stgloorious/EthernetDevBoard.X/hardware/schematics/Schematic_FPGA.pdf

20 | 20 21 21 | 22 22 | 23 23 | 24 24 | 25 25 | 26 26 | 27 27 | 28 28 | 29 29 | 30 30 | 31 31 | 32 32 | 33 33 | 34 34 | 35 35 | 36 36 | 37 37 | 38 38 | 39 39 | 40 40

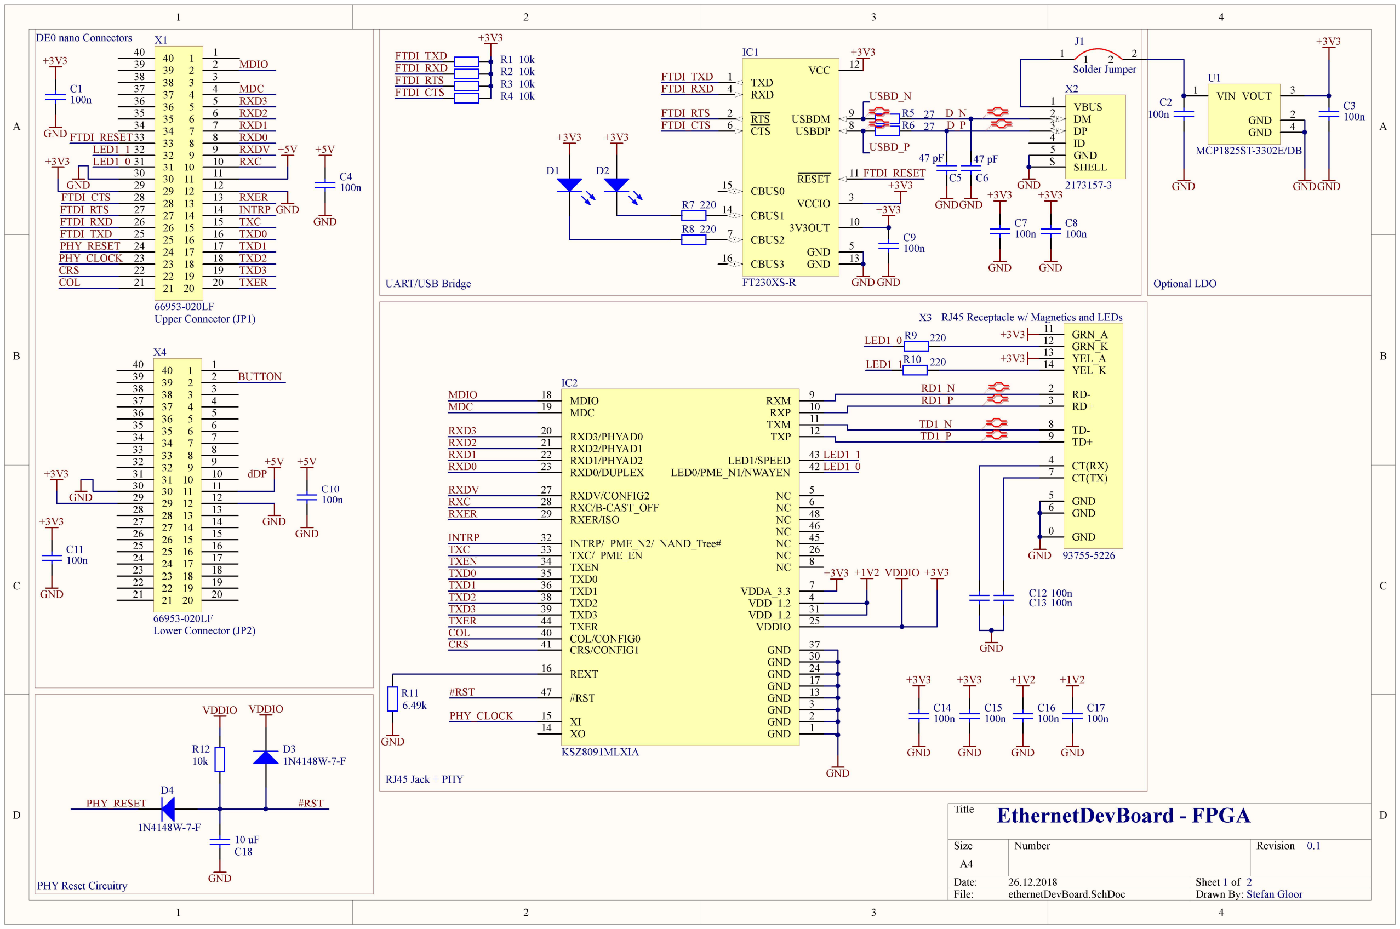
[picture p3: page 1]

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
Title

Size | Number | Revision
A4
Date: | 26.12.2018 | Sheet of
File: | ethernetDevBoard.SchDoc | Drawn By:

# EthernetDevBoard - FPGA

1 2
Stefan Gloor

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
10 10
11 11
12 12
13 13
14 14
15 15
16 16
17 17
18 18
19 19

Upper Connector (JP1)

X1

66953-020LF

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
10 10
11 11
12 12
13 13
14 14
15 15
16 16
17 17
18 18
19 19
20 | 20 21 21 | 22 22 | 23 23 | 24 24 | 25 25 | 26 26 | 27 27 | 28 28 | 29 29 | 30 30 | 31 31 | 32 32 | 33 33 | 34 34 | 35 35 | 36 36 | 37 37 | 38 38 | 39 39 | 40 40

Lower Connector (JP2)

X4

66953-020LF

GND

GND

+5V
+3V3

GND

GND

+5V
+3V3

GND

+3V3 +1V2

MDIO
MDC

RXD3
RXD2
RXD1
RXD0

PHY_CLOCK

#RST

GND

RXDV
RXC
RXER

INTRP
TXC
TXEN
TXD0
TXD1
TXD2
TXD3
TXER
COL
CRS

D4

1N4148W-7-F

D3
1N4148W-7-F

VDDIO

VDDIO

### 10 uF

C18

GND

10k

R12

VDDIO

#RST

R9 220

R10 220

LED1_0

LED1_1

+3V3

+3V3

+3V3

C12 100n
C13 100n

GND

LED1_0

LED1_1

6.49k

R11

GND

MDIO

MDC
RXD3
RXD2

RXD0

RXD1

RXDV
RXC

RXER
INTRP
TXC
TXD0
TXD1
TXD2
TXD3
COL | TXER

CRS

PHY_CLOCK

PHY_RESET

100n

C14

GND

+3V3

100n

C15

GND

+3V3 +1V2

100n

C16

GND

+1V2

100n

C17

GND

100n

C1

GND

+3V3

100n

C11

GND

+3V3

100n

C10

GND

+5V

100n

C4

GND

+5V

TXD 1

RTS 2

VCCIO 3

RXD 4

GND 5

CTS 6

CBUS2 7

USBDP | 8
USBDM | 9
3V3OUT | 10
RESET | 11
VCC | 12
GND | 13

CBUS1 14

CBUS0 15

CBUS3 16

IC1

FT230XS-R | GND

+3V3

FTDI_RESET

+3V3

100n

C7

GND

+3V3

100n

C8

GND

+3V3

VBUS 1
DM 2
DP 3
ID 4
GND 5
SHELL S

X2

GND 2173157-3

R5 27
R6 27

### 47 pF

C5

### 47 pF

C6

R7 220 | GNDGND

R8 220

+3V3 +3V3

FTDI_TXD
FTDI_RXD

FTDI_RTS
FTDI_CTS

100n

C9

GND

R1 10k
R2 10k
R3 10k
R4 10k

FTDI_TXD
FTDI_RXD
FTDI_RTS
FTDI_CTS

+3V3

FTDI_TXD

FTDI_RXD

FTDI_RTS

FTDI_CTS

LED1_0

LED1_1

DE0 nano Connectors

UART/USB Bridge

RJ45 Jack + PHY

PHY Reset Circuitry

PHY_RESET

FTDI_RESET

D_N
D_P

USBD_N

USBD_P

TD1_P

TD1_N

RD1_P

RD1_N

RJ45 Receptacle w/ Magnetics and LEDs

RD- 2
RD+ 3

TD- 8
TD+ 9

CT(RX) 4
CT(TX) 7

GND 5
GND 6

GRN_K 12
YEL_A 13
YEL_K 14

GRN_A 11

GND 0

X3

93755-5226

GND | 1
GND | 2
GND | 3
VDD_1.2 | 4
NC | 5
NC | 6
VDDA_3.3 | 7
GND | 13 GND | 17 GND | 24 GND | 30 GND | 37
NC | 48
NC | 46
NC | 45
VDDIO | 25
NC | 26
NC | 8
RXM | 9
RXP | 10
TXM | 11
TXP | 12
XO 14 | XI 15

REXT 16

MDIO 18
MDC 19

RXD3/PHYAD0 20
RXD2/PHYAD1 21
RXD1/PHYAD2 22
RXD0/DUPLEX 23

RXDV/CONFIG2 27
RXC/B-CAST_OFF 28
RXER/ISO 29

VDD_1.2 31

INTRP/ PME_N2/ NAND_Tree# 32 TXC/ PME_EN 33
TXEN 34
TXD0 35
TXD1 36
TXD2 38
TXD3 39

COL/CONFIG0 40
CRS/CONFIG1 41
LED0/PME_N1/NWAYEN | 42 LED1/SPEED | 43

TXER 44

#RST 47

IC2

KSZ8091MLXIA

D1 | D2

dDP

BUTTON

+3V3

VIN 1

GND | 2
VOUT | 3
GND | 4

U1

MCP1825ST-3302E/DB

+3V3

GND

100n

C3

GND

100n

C2

GND

1

1
2

2

J1

Solder Jumper

Optional LDO
