stgloorious/EthernetDevBoard.X/docs/FPGA6.PNG

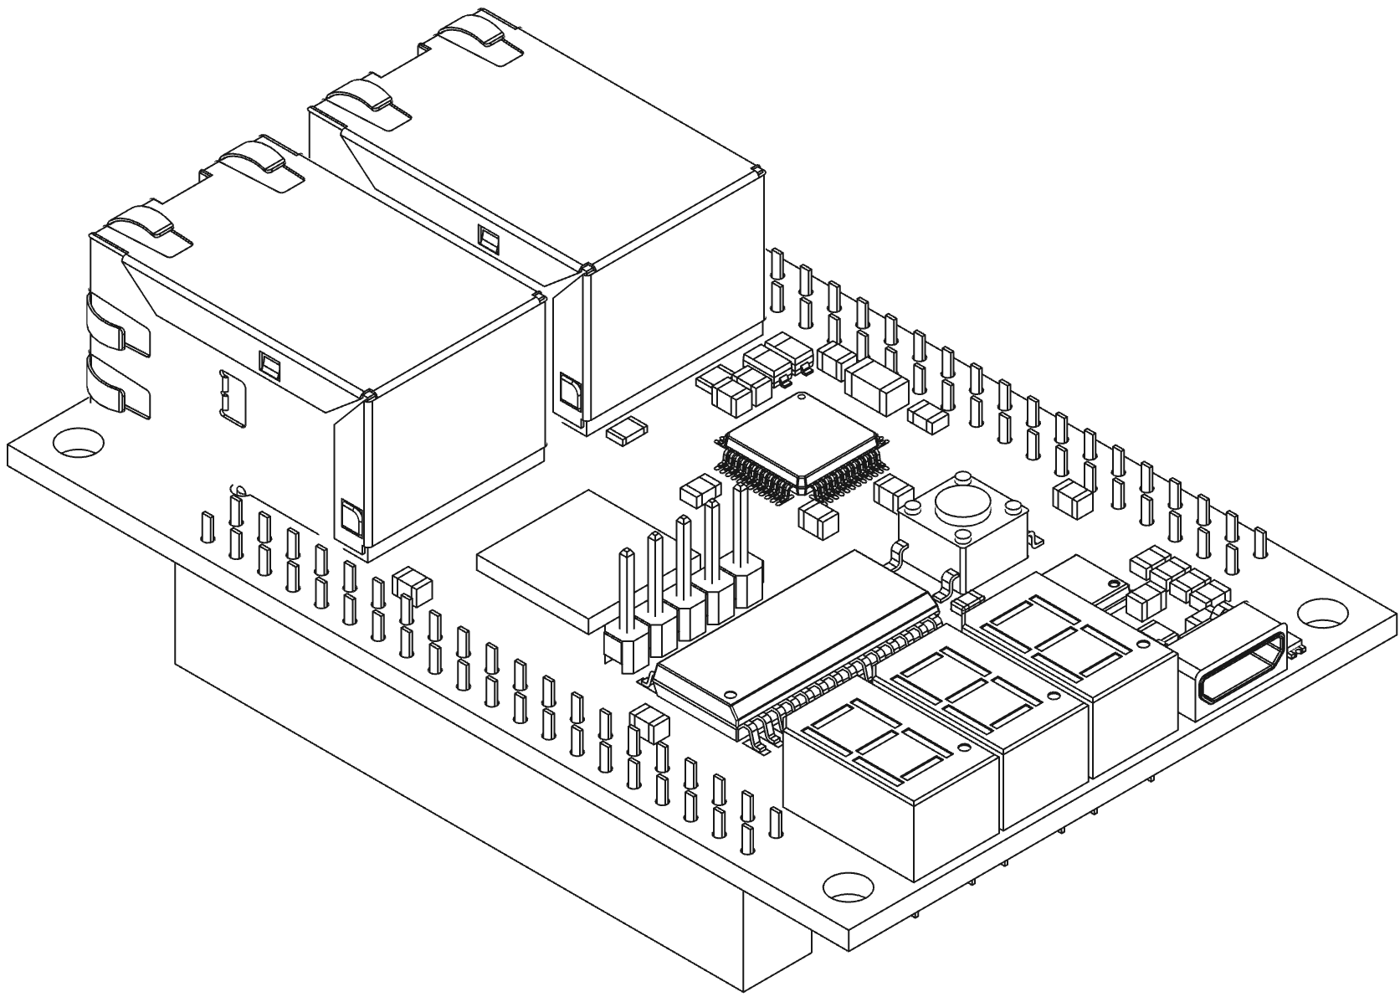
docs/FPGA6.PNG
