stgloorious/EthernetDevBoard.X/docs/hardware_blockdiagram.PNG

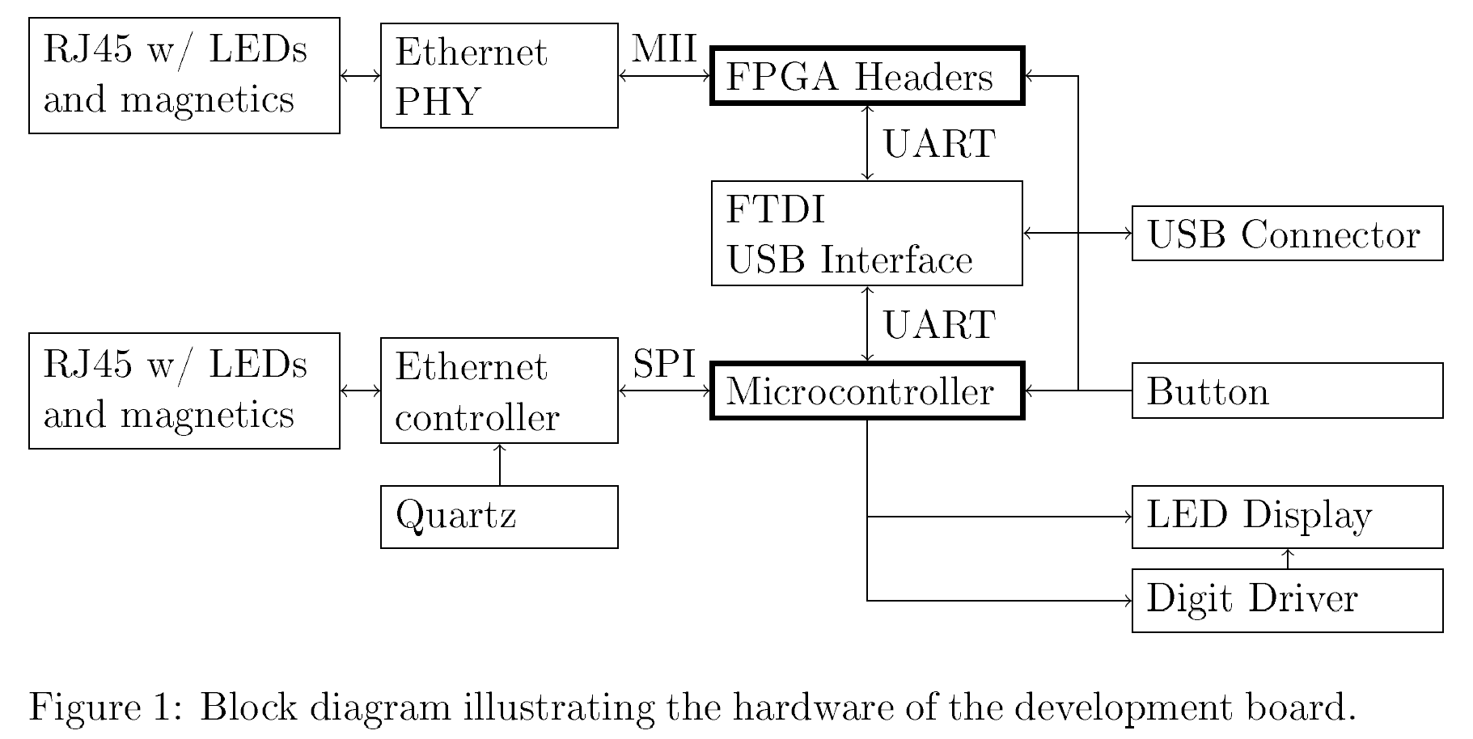
docs/hardware_blockdiagram.PNG
