stgloorious/EthernetDevBoard.X/hardware/photos/1.jpg

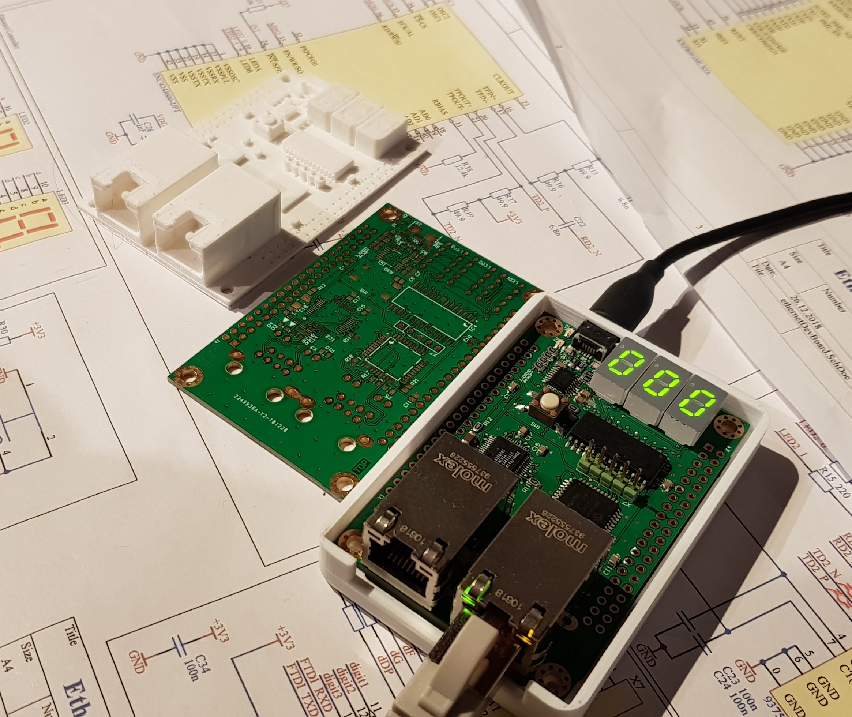
hardware/photos/1.jpg
