stgloorious/EthernetDevBoard.X/hardware/bom/BOM_Full.xls

ETHERNETDEVBOARD_FULL
Mouser No | Mfr. No | Manufacturer | Customer No | Description | RoHS | Lifecycle | Order Qty. | Price (CHF) | Ext.: (CHF)
667-ERJ-6ENF6491V | ERJ-6ENF6491V | Panasonic |  | Thick Film Resistors - SMD 0805 6.49Kohms 1% AEC-Q200 | RoHS Compliant By Exemption |  | 1 | CHF 0.099 | CHF 0.10
667-ERJ-6ENF1002V | ERJ-6ENF1002V | Panasonic |  | Thick Film Resistors - SMD 0805 10Kohms 1% AEC-Q200 | RoHS Compliant By Exemption |  | 7 | CHF 0.099 | CHF 0.69
621-1N4148WQ-7-F | 1N4148WQ-7-F | Diodes Incorporated |  | Diodes - General Purpose, Power, Switching SMT Fast Switching Diode | RoHS Compliant |  | 2 | CHF 0.20 | CHF 0.40
710-885012207086 | 885012207086 | Wurth Electronics |  | Multilayer Ceramic Capacitors MLCC - SMD/SMT WCAP-CSGP 1000pF 0805 10% 50V MLCC | RoHS Compliant |  | 2 | CHF 0.091 | CHF 0.18
710-885012007012 | 885012007012 | Wurth Electronics |  | Multilayer Ceramic Capacitors MLCC - SMD/SMT WCAP-CSGP 22pF 0805 5% 16V MLCC | RoHS Compliant |  | 2 | CHF 0.091 | CHF 0.18
710-885012007032 | 885012007032 | Wurth Electronics |  | Multilayer Ceramic Capacitors MLCC - SMD/SMT WCAP-CSGP 47pF 0805 5% 25V MLCC | RoHS Compliant |  | 2 | CHF 0.099 | CHF 0.20
710-885012207098 | 885012207098 | Wurth Electronics |  | Multilayer Ceramic Capacitors MLCC - SMD/SMT WCAP-CSGP 0.1uF 0805 10% 50V MLCC | RoHS Compliant |  | 25 | CHF 0.064 | CHF 1.60
571-825433-5 | 825433-5 | TE Connectivity | X7 | Headers & Wire Housings 5P SINGLE ROW | RoHS Compliant |  | 1 | CHF 0.697 | CHF 0.70
815-ABMM2-25-E2T | ABMM2-25.000MHZ-E2-T | ABRACON | X6 | Crystals +/-20PPM 25MHZ | RoHS Compliant |  | 1 | CHF 0.827 | CHF 0.83
538-93755-5226 | 93755-5226 | Molex | X3, X5 | Modular Connectors / Ethernet Connectors MXMag FstENeT 4CORE W/TABS W/LED GRN/YLW | RoHS Compliant | New Product | 2 | CHF 6.02 | CHF 12.04
571-2173157-3 | 2173157-3 | TE Connectivity | X2 | USB Connectors SPLASH PROOF MICRO 5P USB B-TYPE | RoHS Compliant |  | 1 | CHF 3.25 | CHF 3.25
649-66953-020LF | 66953-020LF | FCI / Amphenol | X1, X4 | Headers & Wire Housings PCB CONNECTOR 40P | RoHS Compliant |  | 2 | CHF 7.64 | CHF 15.28
579-MCP1825ST3302EDB | MCP1825ST-3302E/DB | Microchip | U1 | LDO Voltage Regulators 500 mA CMOS LDO Vout 3.3V ETR | RoHS Compliant |  | 1 | CHF 0.528 | CHF 0.53
506-2-1437565-8 | 2-1437565-8 | TE Connectivity | SW1 | Tactile Switches TACTILE 260G FORCE S | RoHS Compliant |  | 1 | CHF 0.229 | CHF 0.23
71-CRCW080568R0JNEA | CRCW080568R0JN | Vishay | R22, R23, R24, R25, R | Thick Film Resistors - SMD 1/8watt 68ohms 5% | RoHS Compliant By Exemption |  | 8 | CHF 0.099 | CHF 0.79
71-CRCW080510R0JNEA | CRCW080510R0JNEA | Vishay | R20 | Thick Film Resistors - SMD 1/8watt 10ohms 5% 200ppm | RoHS Compliant By Exemption |  | 1 | CHF 0.099 | CHF 0.10
279-RN73CA-12.4K | RN73C2A12K4BTDF | TE Connectivity | R18 | Thin Film Resistors - SMD 0.1W .1% 10PPM 12.4K | RoHS Compliant |  | 1 | CHF 0.846 | CHF 0.85
667-ERJ-6ENF49R9V | ERJ-6ENF49R9V | Panasonic | R13, R16, R17, R19 | Thick Film Resistors - SMD 0805 49.9ohms 1% AEC-Q200 | RoHS Compliant By Exemption |  | 4 | CHF 0.099 | CHF 0.40
71-CRCW0805220RFKEAH | CRCW0805220RFKEAHP | Vishay | R7, R8, R9, R10, R14, | Thick Film Resistors - SMD 1/2watt 220ohms 1% High Power AEC-Q200 | RoHS Compliant By Exemption |  | 6 | CHF 0.249 | CHF 1.49
71-CRCW080522R0FKEAC | CRCW080522R0FKEAC | Vishay | R5, R6 | Thick Film Resistors - SMD 1/8Watt 22ohms 1% Commercial Use | RoHS Compliant By Exemption | New Product | 2 | CHF 0.099 | CHF 0.20
621-2N7002-F | 2N7002-7-F | Diodes Incorporated | Q1, Q2, Q3 | MOSFET 60V 200mW | RoHS Compliant |  | 3 | CHF 0.189 | CHF 0.57
630-HDSP-7803 | HDSP-7803 | Broadcom Limited | LED1, LED2, LED3 | LED Displays & Accessories Green 571nm 0.3in 7 Segment | RoHS Compliant |  | 3 | CHF 2.90 | CHF 8.70
579-PIC18F25K50-I/SO | PIC18F25K50-I/SO | Microchip | IC4 | 8-bit Microcontrollers - MCU 32 KB Flash RAM, 48 MHz Int. | RoHS Compliant |  | 1 | CHF 2.54 | CHF 2.54
579-ENC424J600-I/PT | ENC424J600-I/PT | Microchip | IC3 | Ethernet ICs 10/100 Base-T Stand alone Ethernet Ctrlr | RoHS Compliant |  | 1 | CHF 3.67 | CHF 3.67
998-KSZ8091MLXIA | KSZ8091MLXIA | Microchip | IC2 | Ethernet ICs 10Base-T/100Base PhysLayerTrnscvr | RoHS Compliant |  | 1 | CHF 1.68 | CHF 1.68
895-FT230XS-R | FT230XS-R | FTDI | IC1 | USB Interface IC USB to Basic Serial UART IC SSOP-16 | RoHS Compliant |  | 1 | CHF 2.03 | CHF 2.03
645-598-8170-107F | 598-8170-107F | Dialight | D1, D2 | Standard LEDs - SMD Green Water Clr 40mcd 570nm | RoHS Compliant |  | 2 | CHF 0.418 | CHF 0.84
710-885012207091 | 885012207091 | Wurth Electronics | C19, C22 | Multilayer Ceramic Capacitors MLCC - SMD/SMT WCAP-CSGP 6800pF 0805 10% 50V MLCC | RoHS Compliant |  | 2 | CHF 0.099 | CHF 0.20
80-C1206X106M4R | C1206X106M4RACTU | KEMET | C18, C25 | Multilayer Ceramic Capacitors MLCC - SMD/SMT 16V 10uF X7R 1206 20% | RoHS Compliant |  | 2 | CHF 1.93 | CHF 3.86
