stgloorious/EthernetDevBoard.X/(list of files, cad)

Other CAD files:
dist/default/production/EthernetDevBoard.X.production.obj
