stgloorious/EthernetDevBoard.X/hardware/mechanical/Mechanical Drawing FPGA.pdf

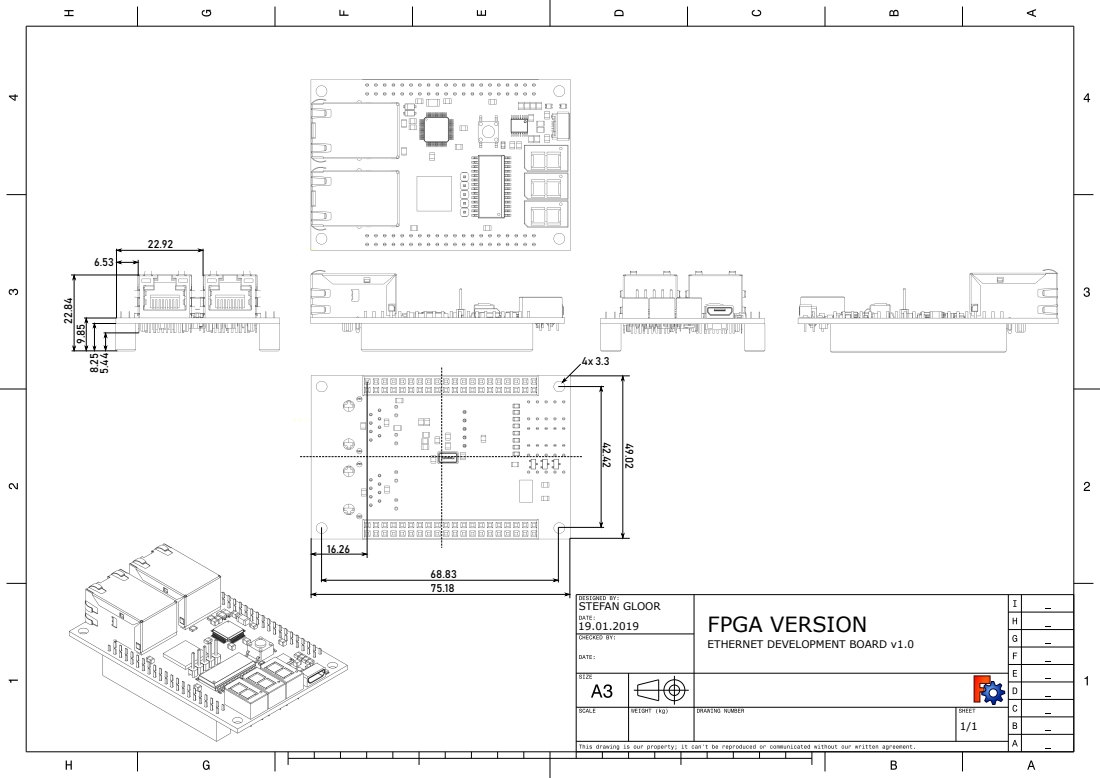
[picture p11: page 1]
STEFAN GLOOR; FPGA VERSION

ETHERNET DEVELOPMENT BOARD v1.0
