stgloorious/EthernetDevBoard.X/hardware/mechanical/Version Differences.pdf

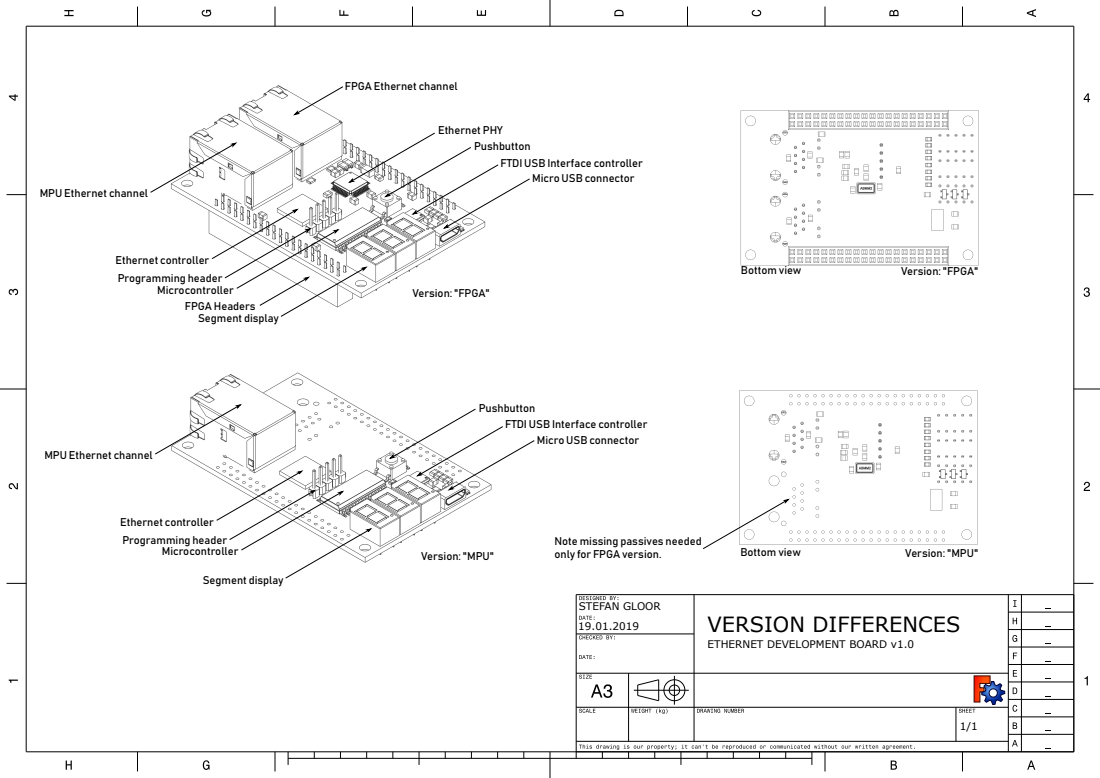
[picture p12: page 1]
STEFAN GLOOR; VERSION DIFFERENCES; Version: "FPGA"; Version: "MPU"; Bottom view; Segment display; FPGA Headers; Microcontroller; Programming header; Ethernet controller

FPGA Ethernet channel

Ethernet PHY
Pushbutton
FTDI USB Interface controller
Micro USB connector

MPU Ethernet channel

Note missing passives needed
only for FPGA version.

ETHERNET DEVELOPMENT BOARD v1.0
