stgloorious/EthernetDevBoard.X/hardware/assembly/Assembly.pdf

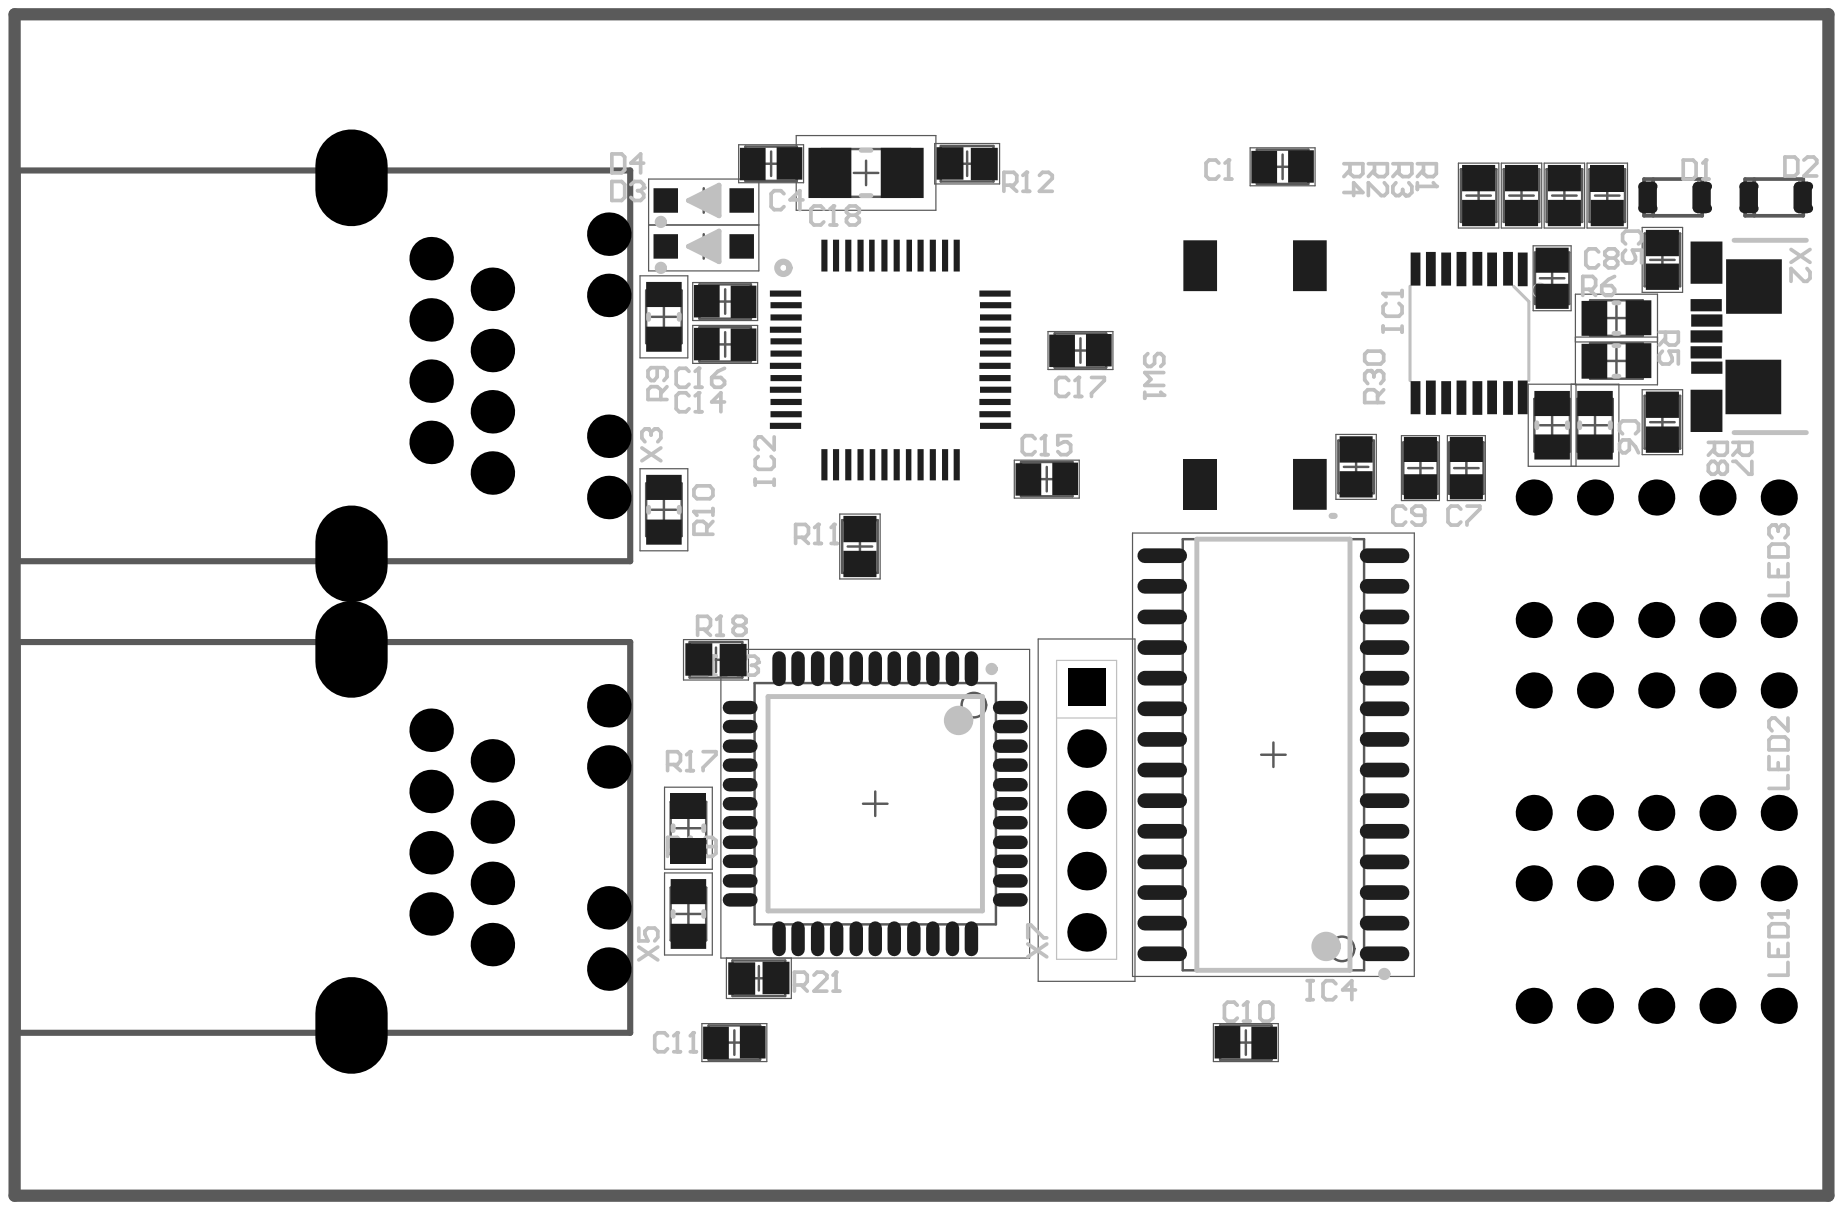
[picture p13: page 1]

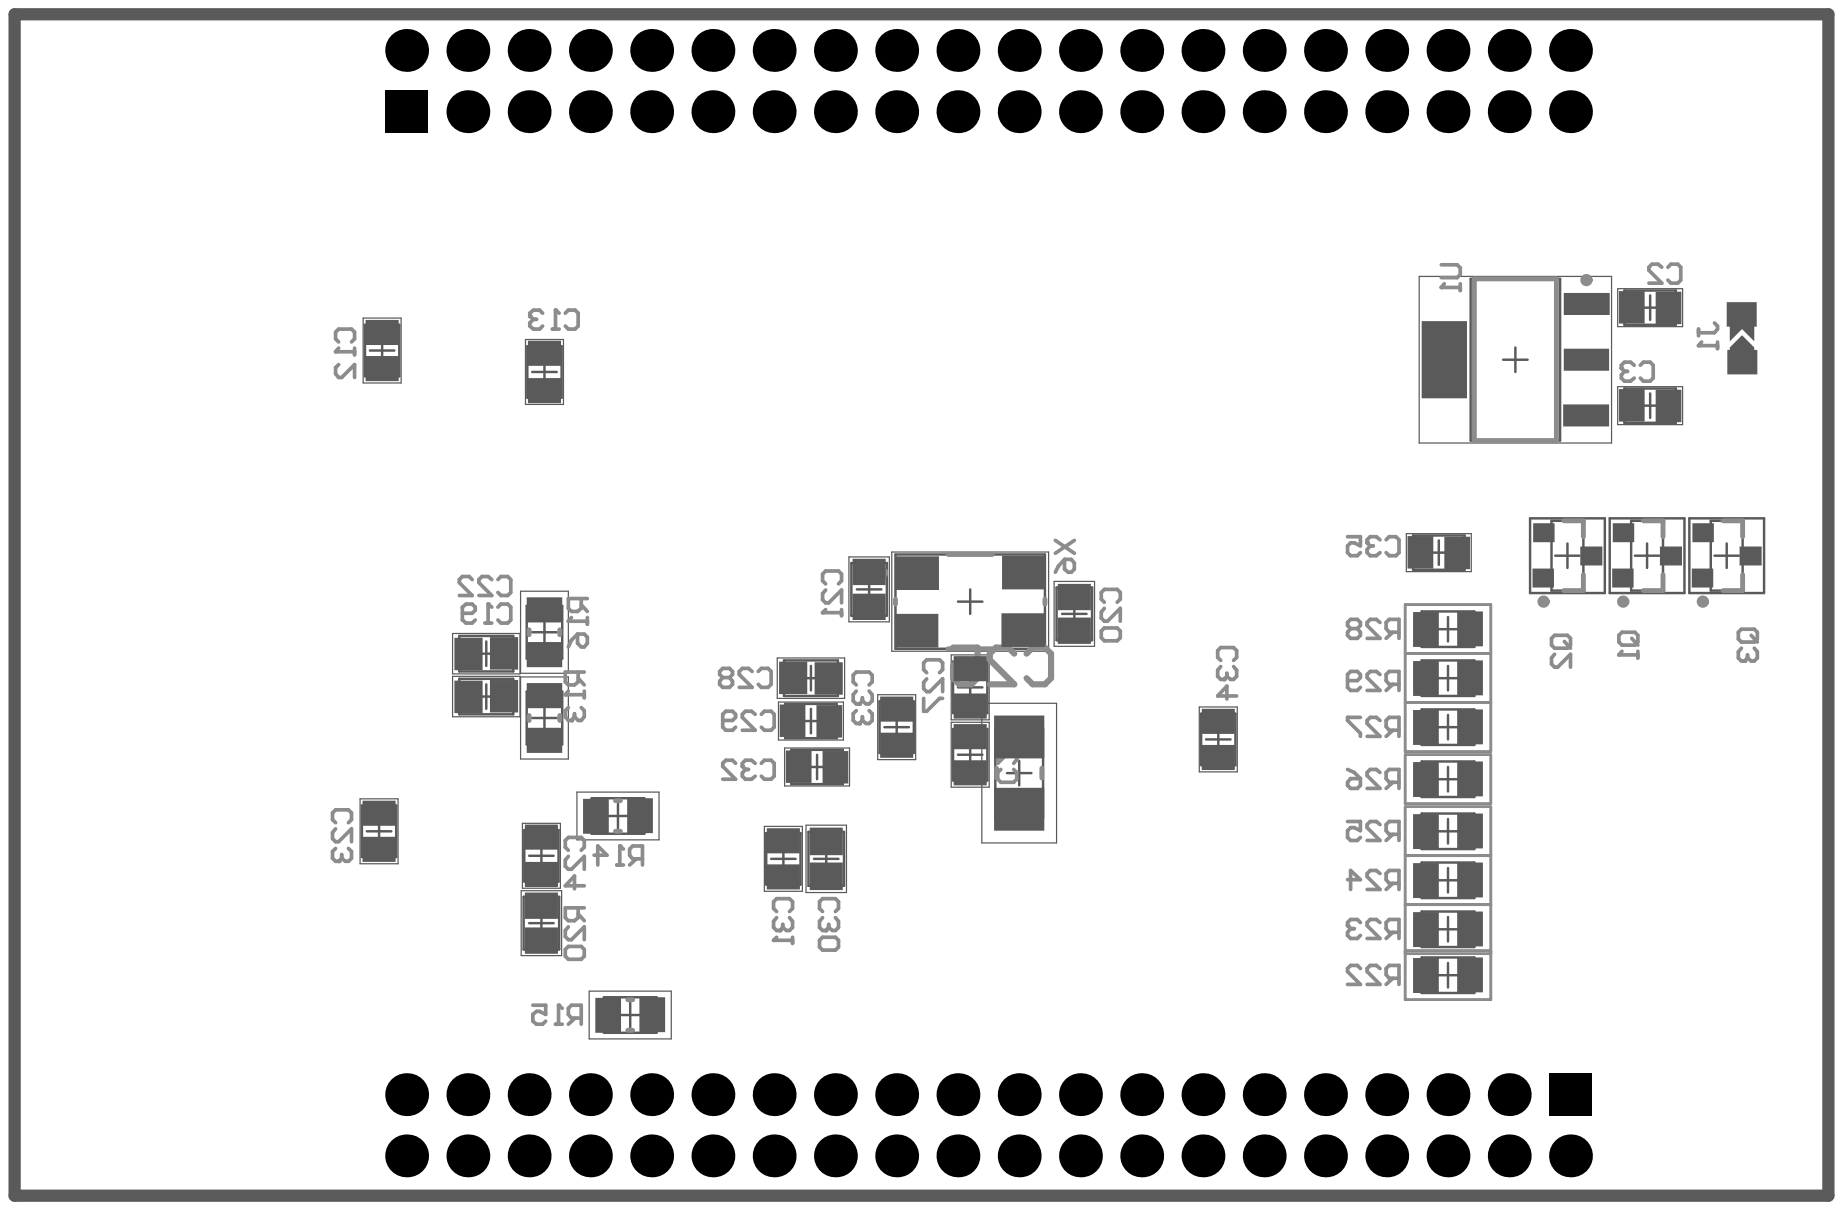
[picture p14: page 2]
