stgloorious/EthernetDevBoard.X/hardware/bom/Version differences.pdf

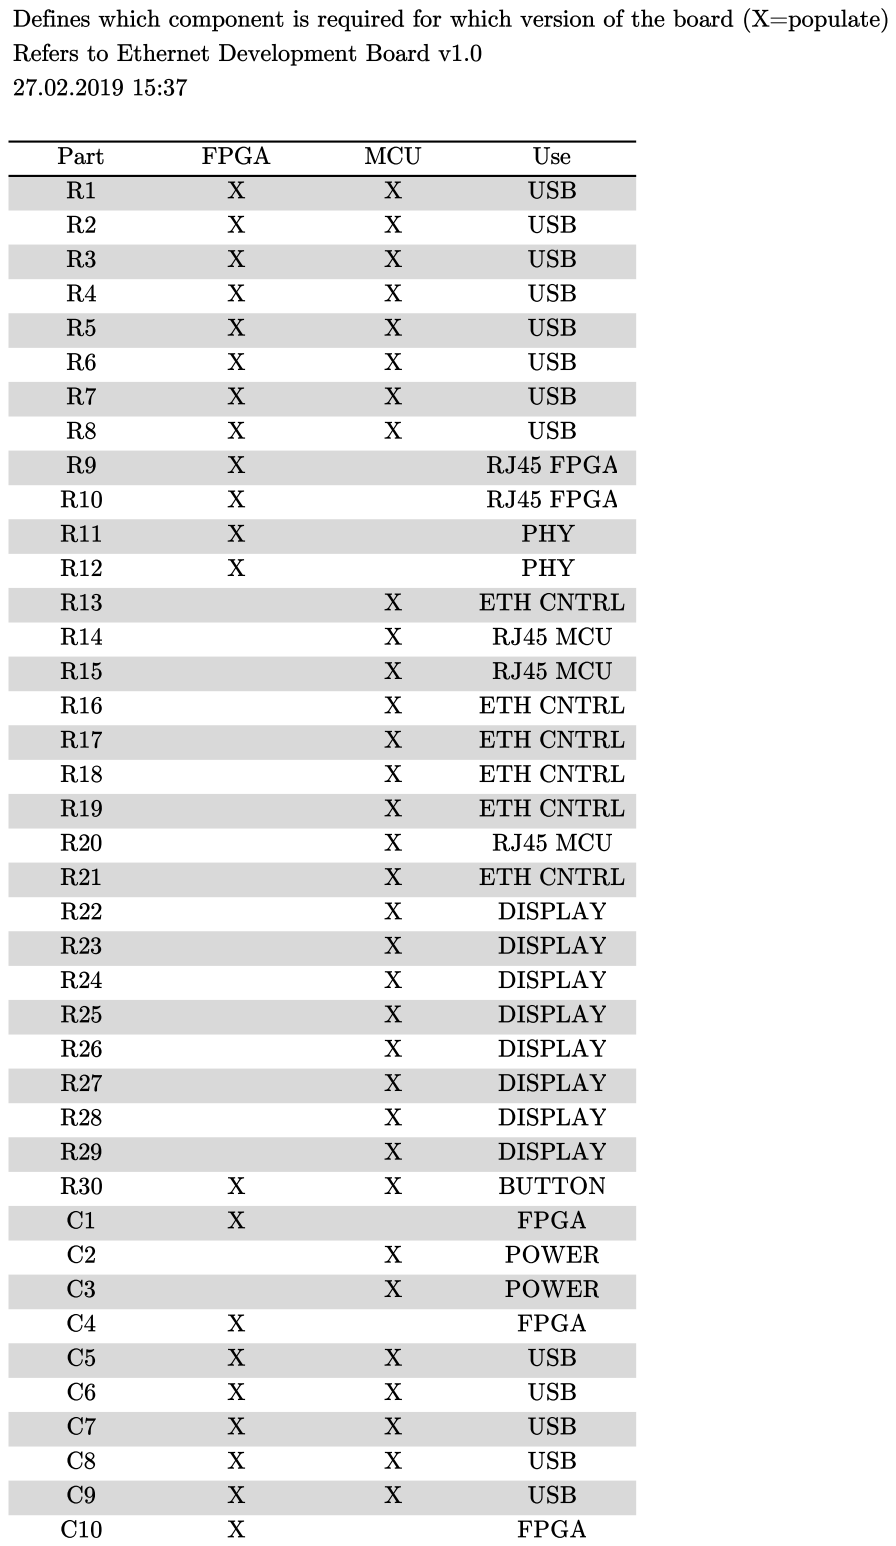
[picture p15: page 1]

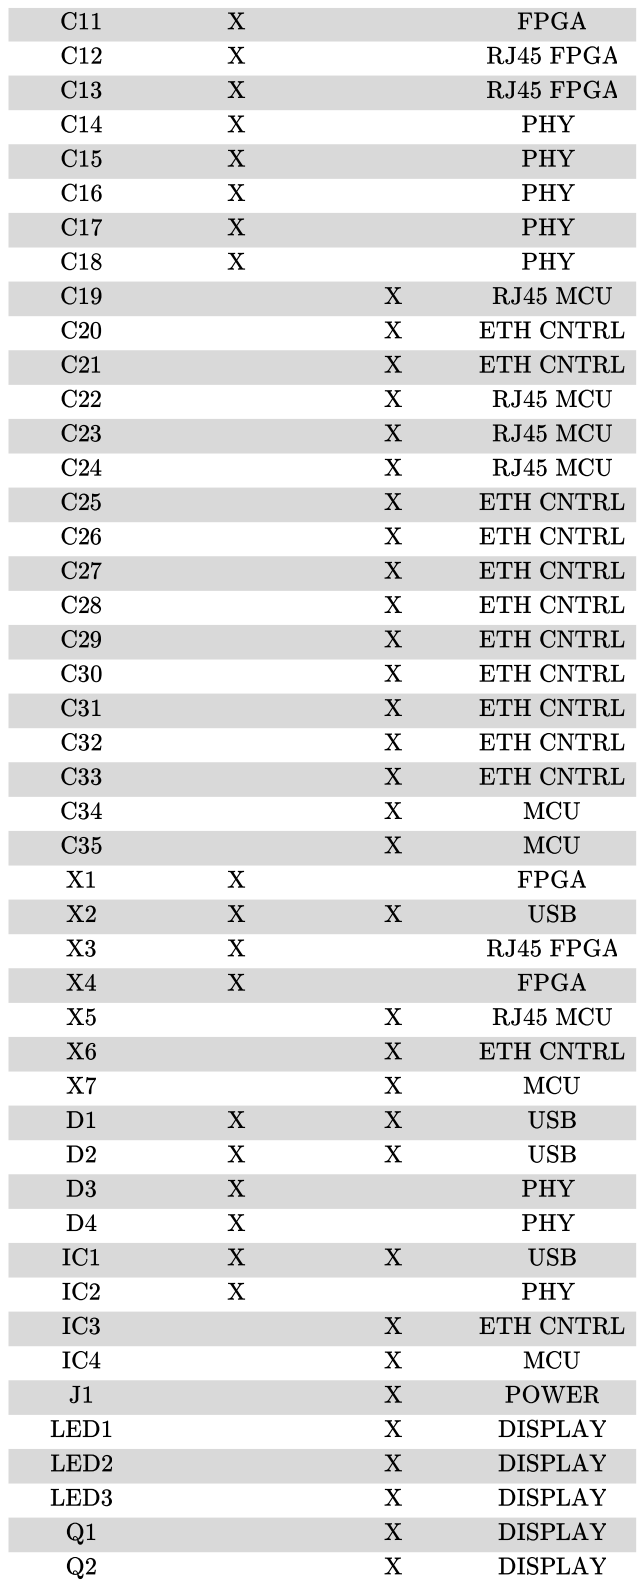
[picture p16: page 2]
