stgloorious/EthernetDevBoard.X/hardware/schematics/Schematic_MPU.pdf

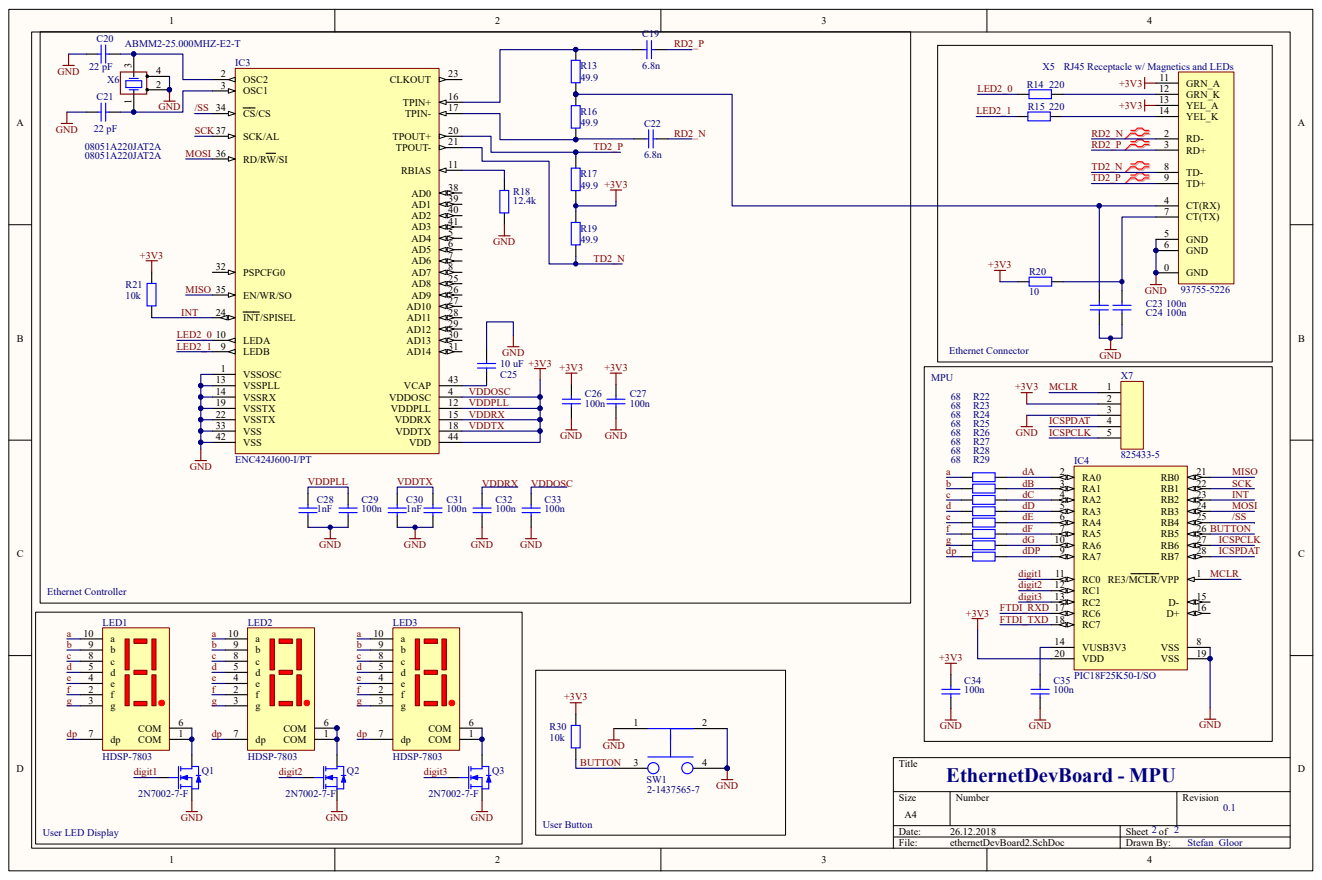
[picture p17: page 1]
