stgloorious/EthernetDevBoard.X/src/system/main.h

/** 
 * \file main.h
 * \brief main
 * \author Stefan Gloor
 * \version 1.0
 * \date  28. December 2018
 * \copyright    
 *  Copyright (C) 2019  Stefan Gloor
 *
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
 *  You should have received a copy of the GNU General Public License
 *  along with this program.  If not, see <http://www.gnu.org/licenses/>.   
 */

#ifndef MAIN_H
#define	MAIN_H

#include <xc.h>
#include <stdint.h>
#include "../eth/ethernetController.h"
#include "../mem/memoryController.h"
#include "../stack/stack.h"
#include "../stack/protocols/ipv4.h"
#include "../system/uart.h"
#include "../system/sevenseg.h"
#include "../stack/backgroundTasks.h"
#include "../system/system.h"



//Button
#define BUTTON_ANSEL	ANSELB &= ~(1<<5)
#define BUTTON_TRISB	TRISB |= (1<<5)
#define BUTTON_STATE	(unsigned)(!(PORTB & (1<<5)))

/**
 * \brief Reads button value and does debouncing and edge-detection
 * \param state Goes to '1' if there's a new edge
 */
void buttonHandler(uint8_t volatile *state);

/**
 * \brief Takes an errorCode type and prints an according message to the user
 * \param err   ErrorCode
 */
void printErrorMessage(error_t err);

/**
 * \brief Prints out debug messages if there is a change in ethernet status
 * \param state Connection state
 */
void printEthernetState (ethernetConnection_t state);

/**
 * \brief Prints out text messages describing the Receive Status Vector.
 * \param rsv Pointer to the first byte out of six of the Receive Status Vector
 */
void printRSV(uint8_t *rsv);


// PIC18F27K42 Configuration Bit Settings

// 'C' source line config statements

// CONFIG1L
#pragma config FEXTOSC = ECH    // External Oscillator Selection (EC (external clock) above 8 MHz; PFM set to high power)
#pragma config RSTOSC = EXTOSC  // Reset Oscillator Selection (EXTOSC operating per FEXTOSC bits (device manufacturing default))

// CONFIG1H
#pragma config CLKOUTEN = OFF   // Clock out Enable bit (CLKOUT function is disabled)
#pragma config PR1WAY = ON      // PRLOCKED One-Way Set Enable bit (PRLOCK bit can be cleared and set only once)
#pragma config CSWEN = ON       // Clock Switch Enable bit (Writing to NOSC and NDIV is allowed)
#pragma config FCMEN = ON       // Fail-Safe Clock Monitor Enable bit (Fail-Safe Clock Monitor enabled)

// CONFIG2L
#pragma config MCLRE = EXTMCLR  // MCLR Enable bit (If LVP = 0, MCLR pin is MCLR; If LVP = 1, RE3 pin function is MCLR )
#pragma config PWRTS = PWRT_OFF // Power-up timer selection bits (PWRT is disabled)
#pragma config MVECEN = ON      // Multi-vector enable bit (Multi-vector enabled, Vector table used for interrupts)
#pragma config IVT1WAY = ON     // IVTLOCK bit One-way set enable bit (IVTLOCK bit can be cleared and set only once)
#pragma config LPBOREN = OFF    // Low Power BOR Enable bit (ULPBOR disabled)
#pragma config BOREN = SBORDIS  // Brown-out Reset Enable bits (Brown-out Reset enabled , SBOREN bit is ignored)

// CONFIG2H
#pragma config BORV = VBOR_2P45 // Brown-out Reset Voltage Selection bits (Brown-out Reset Voltage (VBOR) set to 2.45V)
#pragma config ZCD = OFF        // ZCD Disable bit (ZCD disabled. ZCD can be enabled by setting the ZCDSEN bit of ZCDCON)
#pragma config PPS1WAY = ON     // PPSLOCK bit One-Way Set Enable bit (PPSLOCK bit can be cleared and set only once; PPS registers remain locked after one clear/set cycle)
#pragma config STVREN = ON      // Stack Full/Underflow Reset Enable bit (Stack full/underflow will cause Reset)
#pragma config DEBUG = OFF      // Debugger Enable bit (Background debugger disabled)
#pragma config XINST = OFF      // Extended Instruction Set Enable bit (Extended Instruction Set and Indexed Addressing Mode disabled)

// CONFIG3L
#pragma config WDTCPS = WDTCPS_31// WDT Period selection bits (Divider ratio 1:65536; software control of WDTPS)
#pragma config WDTE = ON        // WDT operating mode (WDT enabled regardless of sleep)

// CONFIG3H
#pragma config WDTCWS = WDTCWS_7// WDT Window Select bits (window always open (100%); software control; keyed access not required)
#pragma config WDTCCS = SC      // WDT input clock selector (Software Control)

// CONFIG4L
#pragma config BBSIZE = BBSIZE_512// Boot Block Size selection bits (Boot Block size is 512 words)
#pragma config BBEN = OFF       // Boot Block enable bit (Boot block disabled)
#pragma config SAFEN = OFF      // Storage Area Flash enable bit (SAF disabled)
#pragma config WRTAPP = OFF     // Application Block write protection bit (Application Block not write protected)

// CONFIG4H
#pragma config WRTB = OFF       // Configuration Register Write Protection bit (Configuration registers (300000-30000Bh) not write-protected)
#pragma config WRTC = OFF       // Boot Block Write Protection bit (Boot Block (000000-0007FFh) not write-protected)
#pragma config WRTD = OFF       // Data EEPROM Write Protection bit (Data EEPROM not write-protected)
#pragma config WRTSAF = OFF     // SAF Write protection bit (SAF not Write Protected)
#pragma config LVP = ON         // Low Voltage Programming Enable bit (Low voltage programming enabled. MCLR/VPP pin function is MCLR. MCLRE configuration bit is ignored)

// CONFIG5L
#pragma config CP = OFF         // PFM and Data EEPROM Code Protection bit (PFM and Data EEPROM code protection disabled)

// CONFIG5H

// #pragma config statements should precede project file includes.
// Use project enums instead of #define for ON and OFF.

#endif	 /* MAIN_H */
