stgloorious/EthernetDevBoard.X/src/stack/protocols/arp.c

/** 
 * \file arp.c
 * \brief Function definitions for IPv4
 * \author Stefan Gloor
 * \version 1.0
 * \date 1. Februar 2019
 * \ingroup arp
 * \copyright    
 *  Copyright (C) 2019  Stefan Gloor
 *
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
 *  You should have received a copy of the GNU General Public License
 *  along with this program.  If not, see <http://www.gnu.org/licenses/>. 
 */

#include <stdlib.h>
#include "arp.h"


arp_tableEntry_t static arp_table [ARP_TABLE_LENGTH];

/* =======================  Receive  ======================= */

void arp_handleNewPacket(ethernetFrame_t *frame) {
    arp_message_t arp;
    if (frame->ethertype != ETHERTYPE_ARP) {
        ethernetController_dropPacket(frame);
        return;
    }

    arp = arp_parseFromRXBuffer(frame);
    if (arp.err.code != ERROR_CODE_SUCCESSFUL) {
        ethernetController_dropPacket(frame);
#if ARP_DEBUG_MESSAGES==true
        UARTTransmitText("[Invalid ARP Message was discarded.]\r\n");
#endif
        return;
    }
#if ARP_DEBUG_MESSAGES==true
    UARTTransmitText("[");
    UARTTransmitText(macToString(arp.senderMACAddress));
    UARTTransmitText(", ");
    UARTTransmitText(ipAdressToString(arp.senderIPAddress));
    UARTTransmitText("]->[");
    UARTTransmitText(macToString(arp.targetMACAddress));
    UARTTransmitText(", ");
    UARTTransmitText(ipAdressToString(arp.targetIPAddress));
    UARTTransmitText("]");
    UART_setFormat(UART_COLOR_FG_BLUE);
    if (arp.fIsProbe)
        UARTTransmitText("[IsProbe]");
    if (arp.fIsGratuitous)
        UARTTransmitText("[IsGratuitous]");
    UART_resetFormat();
#endif 
    arp_sendReply(arp);
    if (!ipv4_isAllZero(&arp.senderIPAddress)) {//Don't allow entries with 0.0.0.0
        arp_setNewEntry(arp.senderMACAddress, arp.senderIPAddress, getMillis());
    }
    ethernetController_dropPacket();
}

arp_message_t static arp_parseFromRXBuffer(ethernetFrame_t *frame) {
    arp_message_t arp;
    uint16_t const offset = 22; //skip NextPacketPointer (2 Bytes), RSV (6 Bytes), 2 MAC addresses (12 Bytes) and EtherType (2 Bytes)

    ethernetController_streamFromRXBuffer(0, frame->memory.start + offset); //Prepare stream

    //Word 0
    arp.htype = (ethernetController_streamFromRXBuffer(1, frame->memory.start + offset) << 8);
    arp.htype |= ethernetController_streamFromRXBuffer(1, frame->memory.start + offset);
    //Word 1
    arp.ptype = (ethernetController_streamFromRXBuffer(1, frame->memory.start + offset) << 8);
    arp.ptype |= ethernetController_streamFromRXBuffer(1, frame->memory.start + offset);
    //Word 2
    arp.hlen = ethernetController_streamFromRXBuffer(1, frame->memory.start + offset);
    arp.plen = ethernetController_streamFromRXBuffer(1, frame->memory.start + offset);
    //Word 3
    arp.operation = (ethernetController_streamFromRXBuffer(1, frame->memory.start + offset) << 8);
    arp.operation |= ethernetController_streamFromRXBuffer(1, frame->memory.start + offset);

    // Sender Addresses
    for (uint8_t i = 0; i < arp.hlen; i++)
        arp.senderMACAddress.address[i] = ethernetController_streamFromRXBuffer(1, frame->memory.start + offset);
    for (uint8_t i = 0; i < arp.plen; i++)
        arp.senderIPAddress.address[i] = ethernetController_streamFromRXBuffer(1, frame->memory.start + offset);
    //Target Addresses
    for (uint8_t i = 0; i < arp.hlen; i++)
        arp.targetMACAddress.address[i] = ethernetController_streamFromRXBuffer(1, frame->memory.start + offset);
    for (uint8_t i = 0; i < arp.plen; i++)
        arp.targetIPAddress.address[i] = ethernetController_streamFromRXBuffer(1, frame->memory.start + offset);

    ethernetController_streamFromRXBuffer(2, frame->memory.start + offset); //Close stream

    if (ipv4_isAllZero(&arp.senderIPAddress)) {//Is it an ARP Probe?
        arp.fIsProbe = 1;
        arp.fIsGratuitous = 0;
    } else {//If not it may be gratuitous
        arp.fIsProbe = 0;
        //Is SPA=TPA and THA set to zero in a ARP request ?
        if (ipv4_cmp(&arp.senderIPAddress, &arp.targetIPAddress) &&
                mac_isAllZero(&arp.targetMACAddress) &&
                arp.operation == ARP_REQUEST) {
            arp.fIsGratuitous = 1;
        } else {
            //Is SPA=TPA and THA=SHA in a ARP reply ?
            if (ipv4_cmp(&arp.senderIPAddress, &arp.targetIPAddress) &&
                    mac_cmp(&arp.senderMACAddress, &arp.targetMACAddress) &&
                    arp.operation == ARP_REPLY) {
                arp.fIsGratuitous = 1;
            } else {
                arp.fIsGratuitous = 0;
            }
        }
    }

    //was there anything unexpected?
    if ((arp.htype != ARP_HTYPE_ETHERNET) || //only Ethernet is supported
            (arp.ptype != ARP_PTYPE_IPv4) || //only IPv4
            (arp.operation > 2) || //There is nothing else than REQUEST (1) and REPLY (2)
            (arp.hlen != ARP_ETHERNET_HLEN) ||
            (arp.plen != ARP_IPv4_PLEN)) {
        arp.err.code = ERROR_ARP_INVALID_VALUES;
        arp.err.module = ERROR_MODULE_ARP;
    } else {
        arp.err.code = ERROR_CODE_SUCCESSFUL;
        arp.err.module = ERROR_MODULE_ARP;
    }

    return arp;
}

/* =======================  Transmit  ======================= */

void static arp_send(arp_message_t arp) {
    memoryField_t field;
    ethernetFrame_t ethFrame;

#if ARP_LINK_BROADCAST == true
    macaddress_t destination;
    mac_setToBroadcast(&destination);
    ethFrame.destination = destination; //broadcast address
#else
    ethFrame.destination = arp.targetMACAddress;
#endif
    ethFrame.length = 36;
    ethFrame.source = ethernetController_getSourceMACAddress(field);
    ethFrame.ethertype = ETHERTYPE_ARP;

    ethernet_txFrameRequest(&ethFrame);

    if (ethFrame.memory.fOutOfMemory) {
        return;
    }

    field.start = ethFrame.memory.start + 8;
    field.end = ethFrame.memory.end;
    field.length = 28;

    ethernetController_streamToTransmitBuffer((arp.htype & 0xff00) >> 8, field);
    ethernetController_streamToTransmitBuffer(arp.htype & 0x00ff, field);
    ethernetController_streamToTransmitBuffer((arp.ptype & 0xff00) >> 8, field);
    ethernetController_streamToTransmitBuffer(arp.ptype & 0x00ff, field);
    ethernetController_streamToTransmitBuffer(arp.hlen, field);
    ethernetController_streamToTransmitBuffer(arp.plen, field);
    ethernetController_streamToTransmitBuffer((arp.operation & 0xff00) >> 8, field);
    ethernetController_streamToTransmitBuffer(arp.operation & 0x00ff, field);
    for (uint8_t i = 0; i < arp.hlen; i++)
        ethernetController_streamToTransmitBuffer(arp.senderMACAddress.address[i], field);
    for (uint8_t i = 0; i < arp.plen; i++)
        ethernetController_streamToTransmitBuffer(arp.senderIPAddress.address[i], field);
    for (uint8_t i = 0; i < arp.hlen; i++)
        ethernetController_streamToTransmitBuffer(arp.targetMACAddress.address[i], field);
    for (uint8_t i = 0; i < arp.plen; i++)
        ethernetController_streamToTransmitBuffer(arp.targetIPAddress.address[i], field);

    ethernetController_sendPacket(ethFrame.memory);
}

/* =======================  Messages  ======================= */
void arp_sendRequest(ipv4_address_t ipSender, ipv4_address_t ipTarget) {
    arp_message_t request;
    macaddress_t senderMAC;
    macaddress_t targetMAC;

    senderMAC = ethernetController_getMacAddress();
    mac_setAllZero(&targetMAC);

    request.hlen = ARP_ETHERNET_HLEN;
    request.plen = ARP_IPv4_PLEN;
    request.htype = ARP_HTYPE_ETHERNET;
    request.ptype = ARP_PTYPE_IPv4;
    request.operation = ARP_REQUEST;
    request.senderIPAddress = ipSender;
    request.senderMACAddress = senderMAC;
    request.targetIPAddress = ipTarget;
    request.targetMACAddress = targetMAC;

    arp_send(request);
}

void static arp_sendReply(arp_message_t request) {
    if (request.operation != ARP_REQUEST)//is it a request?
        return;

    ipv4_address_t myIP = ipv4_getIPSourceAddress();
    if (!(ipv4_cmp(&request.targetIPAddress, &myIP))) //For my IP Address?
        return;

    arp_message_t reply;
    ipv4_address_t senderIP;
    ipv4_address_t targetIP;
    macaddress_t senderMAC;
    macaddress_t targetMAC;

    senderMAC = ethernetController_getMacAddress();
    targetMAC = request.senderMACAddress; //send it back
    senderIP = ipv4_getIPSourceAddress();
    targetIP = request.senderIPAddress; //send it back

    reply.hlen = ARP_ETHERNET_HLEN;
    reply.plen = ARP_IPv4_PLEN;
    reply.htype = ARP_HTYPE_ETHERNET;
    reply.ptype = ARP_PTYPE_IPv4;
    reply.operation = ARP_REPLY;
    reply.senderIPAddress = senderIP;
    reply.senderMACAddress = senderMAC;
    reply.targetIPAddress = targetIP;
    reply.targetMACAddress = targetMAC;

    arp_send(reply);
#if ARP_DEBUG_MESSAGES==true
    UART_setFormat(UART_COLOR_BG_BLUE); //blue color, Primary font
    UARTTransmitText("[Reply sent to ");
    UARTTransmitText(macToString(reply.targetMACAddress));
    UARTTransmitText(", ");
    UARTTransmitText(ipAdressToString(reply.targetIPAddress));
    UARTTransmitText("]");
    UART_resetFormat();
#endif
}

/* =======================  Collision Check  ======================= */
error_t static arp_probe(ipv4_address_t ipTarget, linkState_t link) {
    time_t timeStart; // Used to calculate the time passed
    time_t waitingTime; // Specifies the number of milliseconds which have to pass before doing something
    ipv4_address_t ipSender;
    uint8_t static probeCounter = 0; //counts how many probes already have been sent
    error_t err;

    enum states {
        PREPARING_PROBE, WAITING_TO_SEND, SENDING_PROBE, ARP_ENTRY_FOUND
    };
    uint8_t static state = PREPARING_PROBE;
    uint8_t index;
    err.module = ERROR_MODULE_ARP;

    if (link == NO_LINK) {
        state = PREPARING_PROBE;
        probeCounter = 0;
        err.code = ERROR_ARP_CONNECTION_FAILED;
        return err; //don't bother to continue
    }

    if (arp_checkForEntry(ipTarget, &index)) {
        state = ARP_ENTRY_FOUND;
    }

    switch (state) {//State Machine
        case PREPARING_PROBE:
            ipv4_setToAllZero(&ipSender); //"The 'sender IP address' field MUST be set to all zeroes" - RFC 5227
            timeStart = getMillis(); //keep track when we started counting the waitingTime
            waitingTime = rand() % ARP_PROBE_WAIT; //"[...] then wait for a random time interval selected uniformly in the range zero to PROBE_WAIT" - RFC 5227
            state = WAITING_TO_SEND;
            err.code = ERROR_ARP_WAITING;
            break;
        case WAITING_TO_SEND:
            if (getMillis() - timeStart >= waitingTime) {//Are we done waiting for the first probe?
                state = SENDING_PROBE;
                //"[...] each of these probe packets spaced randomly and uniformly, PROBE_MIN to PROBE_MAX seconds apart." - RFC 5227
                waitingTime = (rand() % (ARP_PROBE_MAX - ARP_PROBE_MIN)) + ARP_PROBE_MIN;
            }
            err.code = ERROR_ARP_WAITING;
            break;
        case SENDING_PROBE:
            if (probeCounter == 0 || (getMillis() - timeStart) > waitingTime) {
                timeStart = getMillis(); //remember time the last packet was sent

                if (probeCounter < ARP_PROBE_NUM) {
#if ARP_DEBUG_MESSAGES==true
                    UARTTransmitText("[ARP]: Sending Probe for ");
                    UARTTransmitText(ipAdressToString(ipTarget));
                    UARTTransmitText(" (reply to ");
                    UARTTransmitText(ipAdressToString(ipSender));
                    UARTTransmitText(")\n\r");
#endif
                    arp_sendRequest(ipSender, ipTarget);
                }
                if (probeCounter >= ARP_PROBE_NUM) {//RFC suggests to wait *after* the transmission
                    probeCounter = 0;
                    state = PREPARING_PROBE;
                    err.code = ERROR_ARP_MAXIMUM_NUMBER_OF_PROBES_REACHED; //That would be the "normal" case; the probing was negative
                } else {
                    err.code = ERROR_ARP_WAITING; //there are more probes to send
                    probeCounter++;
                }
            }
            break;
        case ARP_ENTRY_FOUND:
            probeCounter = 0;
            state = PREPARING_PROBE;
            err.code = ERROR_ARP_IPv4_ADDRESS_CONFLICT;
    }
    return err; //Is reached as long as link is connected
}

error_t static arp_gratuitous(ipv4_address_t ip, linkState_t link) {
    uint8_t static announceCounter = 0;
    uint8_t static state = 0;
    time_t static timeStart = 0;
    uint8_t index;
    error_t err;

    enum states {
        INIT, WAIT_FOR_ANNOUNCE, ANNOUNCING, ENTRY_FOUND
    };
    err.module = ERROR_MODULE_ARP;
    err.code = ERROR_ARP_WAITING;

    if (link == NO_LINK) {
        announceCounter = 0;
        state = INIT;
        err.code = ERROR_ARP_CONNECTION_FAILED;
        return err;
    }

    if (arp_checkForEntry(ip, &index)) {
        state = ENTRY_FOUND;
    }

    switch (state) {//state machine
        case INIT://used to determine the start time
            err.code = ERROR_ARP_WAITING;
            timeStart = getMillis();
            state = WAIT_FOR_ANNOUNCE;
            break;
        case WAIT_FOR_ANNOUNCE://waiting ANNOUNCE_WAIT
            err.code = ERROR_ARP_WAITING;
            if ((getMillis() - timeStart) > ARP_ANNOUNCE_WAIT) {
                state = ANNOUNCING; //done waiting
                announceCounter = 0;
            }
            break;
        case ANNOUNCING://Ready to announce
            err.code = ERROR_ARP_WAITING;
            if ((announceCounter == 0) || (getMillis() - timeStart) > ARP_ANNOUNCE_INTERVAL) {//Wait ANNOUNCE_INTERVAL between announcements
#if ARP_DEBUG_MESSAGES==true
                UARTTransmitText("[ARP]: Sending Gratuitous ARP request for ");
                UARTTransmitText(ipAdressToString(ip));
                UARTTransmitText("\n\r");
#endif
                timeStart = getMillis(); //memorise time when the last announcement was sent
                arp_sendRequest(ip, ip); //Sender and target IP are the newly selected address
                announceCounter++;
            }
            if (announceCounter >= ARP_ANNOUNCE_NUM) {
                //reset everything
                announceCounter = 0;
                state = INIT;
                err.code = ERROR_CODE_SUCCESSFUL;
            }
            break;
        case ENTRY_FOUND:
            announceCounter = 0;
            state = INIT;
            err.code = ERROR_ARP_IPv4_ADDRESS_CONFLICT;
            break;

    }
    return err;
}

/* =======================  Background work ======================= */

error_t arp_background(linkState_t link) {
    error_t static err;
    error_t errProbe;
    error_t errAnnounce;
    bool_t static fAnnounce = false;
    int8_t static state = 0;
    ipv4_address_t static ipPreliminary;
    err.code = ERROR_ARP_WAITING;
    err.module = ERROR_MODULE_ARP;

    switch (state) {
        case 0:


            ipPreliminary = ipv4_getPreliminaryIPSourceAddress();
            if (ipv4_SrcAddrChanged(&err)) {//The IPv4 module wants to use a different source address than before
                errProbe.code = arp_probe(ipPreliminary, link).code;
                switch (errProbe.code) {
                    case ERROR_ARP_IPv4_ADDRESS_CONFLICT:
#if ARP_DEBUG_MESSAGES==true
                        UARTTransmitText("[ARP]: Conflict during probing.\n\r");
#endif
                        break;
                    case ERROR_ARP_MAXIMUM_NUMBER_OF_PROBES_REACHED:
#if ARP_DEBUG_MESSAGES==true
                        UARTTransmitText("[ARP]: Nobody answered to probes.\n\r");
#endif
                        state = 1;
                        break;
                    case ERROR_ARP_WAITING:
                        break;
                    case ERROR_ARP_CONNECTION_FAILED:
#if ARP_DEBUG_MESSAGES==true
                        UARTTransmitText("[ARP]: Operation was interrupted because link was lost.\n\r");
#endif
                        break;
                    default:
#if ARP_DEBUG_MESSAGES==true
                        UARTTransmitText("[ARP]: An unknown error occured.\n\r");
#endif
                        break;
                }
            }
            err.code = errProbe.code;

            break;

        case 1:
            errAnnounce = arp_gratuitous(ipPreliminary, link);
            err.code = errAnnounce.code;
            if (err.code == ERROR_ARP_IPv4_ADDRESS_CONFLICT) {
#if ARP_DEBUG_MESSAGES==true
                UARTTransmitText("[ARP]: Conflict during announcement.\n\r");
#endif
                state = 0;
            }
            if (errAnnounce.module == ERROR_MODULE_ARP &&
                    errAnnounce.code == ERROR_CODE_SUCCESSFUL) {
#if ARP_DEBUG_MESSAGES==true
                UARTTransmitText("[ARP]: All announcements sent.\n\r");
#endif
                state = 0;
            }
            break;
    }

    return err;
}

/* =======================  Table  ======================= */

uint8_t arp_checkForEntry(ipv4_address_t ip, uint8_t * index) {
    for (uint8_t i = 0; i < ARP_TABLE_LENGTH; i++) {
        if (ipv4_cmp(&arp_table[i].ip, &ip)) {
            if ((getMillis() - arp_table[i].timeCreated) < ARP_TABLE_ENTRY_TTL) {//not expired?
                //if an entry is expired it is just ignored; old entries are overwritten anyways when writing new ones.
                *index = i; //save where the entry is
                return 1; //don't check further
            }
        }
    }
    return 0;
}

macaddress_t arp_getEntryFromTable(uint8_t index) {
    return arp_table[index].mac;
}

void static arp_setNewEntry(macaddress_t mac, ipv4_address_t ip, time_t timestamp) {
    time_t minSeconds = 0xffffffff; //max value
    uint8_t oldestIndex = 0;
    //Loop through table to find oldest entry
    for (uint8_t i = 0; i < ARP_TABLE_LENGTH; i++) {
        if (arp_table[i].timeCreated <= minSeconds) {
            minSeconds = arp_table[i].timeCreated;
            oldestIndex = i;
        }
        if (mac_cmp(&arp_table[i].mac, &mac) && ipv4_cmp(&arp_table[i].ip, &ip)) {
            //If there is already an entry with this MAC&IP combination, stop checking and overwrite it
            oldestIndex = i;
            break;
        }
    }
    //Create new entry, replacing the oldest one
    arp_table[oldestIndex].ip = ip;
    arp_table[oldestIndex].mac = mac;
    arp_table[oldestIndex].timeCreated = timestamp;
#if ARP_DEBUG_MESSAGES==true
    if (!((mac_isAllZero(&mac)) && ipv4_isAllZero(&ip))) {
        UART_setFormat(UART_COLOR_BG_BLUE); //blue color, Primary font
        UARTTransmitText("[ARP]: New entry created for ");
        UARTTransmitText(ipAdressToString(ip));
        UARTTransmitText(" (");
        UARTTransmitText(macToString(mac));
        UARTTransmitText(")(");
        UARTTransmitText(intToString(oldestIndex,10));
        UARTTransmitText(")");
        UART_resetFormat();
    }
#endif
}

void arp_init() {
    ipv4_address_t ip;
    macaddress_t mac;
    ipv4_setToAllZero(&ip);
    mac_setAllZero(&mac);
    for (uint8_t i = 0; i < ARP_TABLE_LENGTH; i++) {
        arp_table[i].ip = ip;
        arp_table[i].mac = mac;
        arp_table[i].timeCreated = 0;
    }
#if ARP_DEBUG_MESSAGES==true
    UARTTransmitText("[ARP]: Table was reset successfully.\n\r");
#endif
}

void printArpTable() {
    for (uint8_t i = 0; i < ARP_TABLE_LENGTH; i++) {
        UARTTransmitText(arpEntryToString(arp_table[i]));
        UARTTransmitText("\n\r");
    }
}
