stgloorious/EthernetDevBoard.X/src/eth/ethernet.c

/**
 * \file ethernet.c
 * \brief Acts as interface between hardware/medium and upper laying protocols
 * \author Stefan Gloor
 * \version 1.0
 * \date 16. Februar 2019
 * \ingroup ethernet
 * \copyright    
 *  Copyright (C) 2019  Stefan Gloor
 *
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
 *  You should have received a copy of the GNU General Public License
 *  along with this program.  If not, see <http://www.gnu.org/licenses/>. 
 */

#include "../eth/ethernet.h"
#include "../enc424j600/ENC424J600.h"
#include "../system/uart.h"
#include "../stack/time.h"

error_t ethernet_txFrameRequest(ethernetFrame_t *frame) {
    // "I want to send an ethernet frame"
    error_t err;
    err.module = ERROR_MODULE_ETHERNET;
    err.code = ERROR_CODE_SUCCESSFUL;
    frame->memory = memory_txFrameRequest(frame->length);

    if (frame->memory.fOutOfMemory) {
        //There is no more memory left
        err.module = ERROR_MODULE_MEMORY;
        err.code = ERROR_MEMORY_OUT_OF_MEMORY;
        return err;
    }
    if (!frame->memory.fIsAssigned) {
        //the fIsAssigned flag should never be cleared if the fOutOfMemory flag is
        err.module = ERROR_MODULE_MEMORY;
        err.code = ERROR_MEMORY_UNKNOWN;
        return err;
    }

    ethernetController_writeDestinationMACAddress(frame->destination, frame->memory);
    ethernetController_writeEtherTypeFieldToBuffer(frame->ethertype, frame->memory);
    return err;
}

error_t ethernet_rxGetNewFrame(ethernetFrame_t *frame) {
    uint32_t static counter = 0;
    error_t err;
    err.module = ERROR_MODULE_ETHERNET;
    err.code = ERROR_CODE_SUCCESSFUL; //per default successful

    /* =======================  Memory and basic information about the packet  ======================= */
    frame->tReceived = getMillis(); //add a timestamp to every received packet
    frame->memory.start = ethernetController_getNextPacketPointer(); //Get the address of the packet that should be processed next
    ethernetController_updateNextPacketPointer(); //read out the nextPacketPointer of the current frame, so we know where the next frame will begin
    frame->memory.fIsAssigned = 1; //Not really needed, for completeness
    frame->receiveStatusVector = ethernetController_getRSV(frame->memory.start); //get the RSV for that packet
    frame->memory.length = frame->receiveStatusVector.length;
    //frame->length = frame->receiveStatusVector.length;

    //Now that we have the packets length we can work out where it ends
    if (frame->memory.start + frame->memory.length > END_OF_MEMORY_ADDRESS) {//Does it wrap around?
        //Work out the wrapped-around address
        frame->memory.end = frame->memory.length - ((END_OF_MEMORY_ADDRESS - RX_DATA_START_ADDRESS) - frame->memory.start) + RX_DATA_START_ADDRESS;
    } else {//Packet does not wrap around in memory
        frame->memory.end = frame->memory.start + frame->memory.length;
    }
    frame->ethertype = ethernetController_getEtherTypeField(frame->memory);

#if ETHERNET_SHOW_INCOMING_PACKET_DEBUG_MESSAGES==true
    UARTTransmitText("[");
    UARTTransmitText(intToString(counter++, 10));
    UARTTransmitText("]");
#endif


    /* =======================  Processing the FLags from the Receive Status Vector  ======================= */
    if (frame->receiveStatusVector.broadcast)
#if ETHERNET_SHOW_INCOMING_PACKET_DEBUG_MESSAGES==true
        UARTTransmitText("[Broadcast]");
#endif
    if (frame->receiveStatusVector.unicast)
#if ETHERNET_SHOW_INCOMING_PACKET_DEBUG_MESSAGES==true
        UARTTransmitText("[Unicast]");
#endif
    if (!frame->receiveStatusVector.receivedOk) {
#if ETHERNET_SHOW_INCOMING_PACKET_DEBUG_MESSAGES==true
        UART_setFormat(UART_COLOR_BG_RED); //Red color
        UARTTransmitText("[Symbol Errors]");
        UART_resetFormat();
#endif
    }


    /* ======================= Distributing the packet to the responsible protocol  ======================= */

    switch (frame->ethertype) {
        case ETHERTYPE_ARP:
#if ETHERNET_SHOW_INCOMING_PACKET_DEBUG_MESSAGES==true
            UART_setFormat(UART_COLOR_BG_BLUE);
            UARTTransmitText("[");
            UARTTransmitText(etherTypeToString(ETHERTYPE_ARP));
            UARTTransmitText("]");
            UART_resetFormat();
#endif
            arp_handleNewPacket(frame);

            break;
        case ETHERTYPE_IPv4:
#if ETHERNET_SHOW_INCOMING_PACKET_DEBUG_MESSAGES==true
            UART_setFormat(UART_COLOR_BG_MAGENTA);
            UARTTransmitText("[");
            UARTTransmitText(etherTypeToString(ETHERTYPE_IPv4));
            UARTTransmitText("]");
            UART_resetFormat();
#endif
            ipv4_handleNewPacket(frame);
            break;
        default:
#if ETHERNET_SHOW_INCOMING_PACKET_DEBUG_MESSAGES==true
            UART_setFormat(UART_COLOR_BG_RED);
            UARTTransmitText("[");
            UARTTransmitText(etherTypeToString(ETHERTYPE_UNKNOWN));
            UARTTransmitText("][");
            UARTTransmitText(macToString(frame->source));
            UARTTransmitText("->");
            UARTTransmitText(macToString(frame->destination));
            UARTTransmitText("][");
            UARTTransmitText(etherTypeToString(frame->ethertype));
            UARTTransmitText("][L=");
            UARTTransmitText(intToString(frame->length, 10));
            UARTTransmitText("] ");
            UART_resetFormat();
#endif
            ethernetController_dropPacket();
            break;
    }


    /*  UARTTransmitText("[");
      UARTTransmitText(intToString(frame->memory.start,10));
      UARTTransmitText(" to ");
      UARTTransmitText(intToString(frame->memory.end,10));
      UARTTransmitText(" (");
      UARTTransmitText(intToString(frame->memory.length,10));
      UARTTransmitText(")]");*/


#if ETHERNET_SHOW_INCOMING_PACKET_DEBUG_MESSAGES==true
    UARTTransmitText("\n\r");
#endif
    return err;
}
