stgloorious/EthernetDevBoard.X/(commit log)

2019-02-28 Initial draft
    [EthMPU.X.production.obj]
2019-02-28 updated receive functions to support memory fields
    [EthMPU.X.production.obj, EthernetDevBoard.X.production.obj]
2019-03-01 added basic ethernet controller settings
    [EthernetDevBoard.X.production.obj]
2019-03-01 ipv4 rx implement
    [EthernetDevBoard.X.production.obj]
2019-03-17 Packet loss bug fix
    If data was streamed from the RX buffer the tail pointer was updated too early which lead to packets being missed
    [EthernetDevBoard.X.production.obj]
2019-03-17 Added gratuitous ARP and fixed probing
    [EthernetDevBoard.X.production.obj]
2019-03-17 image test
    [EthernetDevBoard.X.production.obj]
2019-03-31 hardware files
    [BOM_Full.xls, BOM_MPU.xls, EthernetDevBoard.X.production.obj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]
2019-03-31 background flag bugfix
    Seems like the problem was that a pointer argument was for a different structure, resulting in corruption of the next element in the stack structure (which was the background handler)
    [EthernetDevBoard.X.production.obj]
2019-03-31 arp fix
    [EthernetDevBoard.X.production.obj]
2019-04-03 updated docs
    [EthernetDevBoard.X.production.obj]
2019-04-22 icmp draft
    [EthernetDevBoard.X.production.obj]
2019-05-04 UDP/TCP draft
    [EthernetDevBoard.X.production.obj]
2020-02-02 Enhanced debug log, minor changes, typos
    [EthernetDevBoard.X.production.obj]
